AK-Homberger/NMEA2000-TempPressure/README.md

# NMEA2000 Temperature and Pressure
This repository shows how to  measure temperature and barometric pressure with a BMP280 sensor and send it to NMEA2000 network.

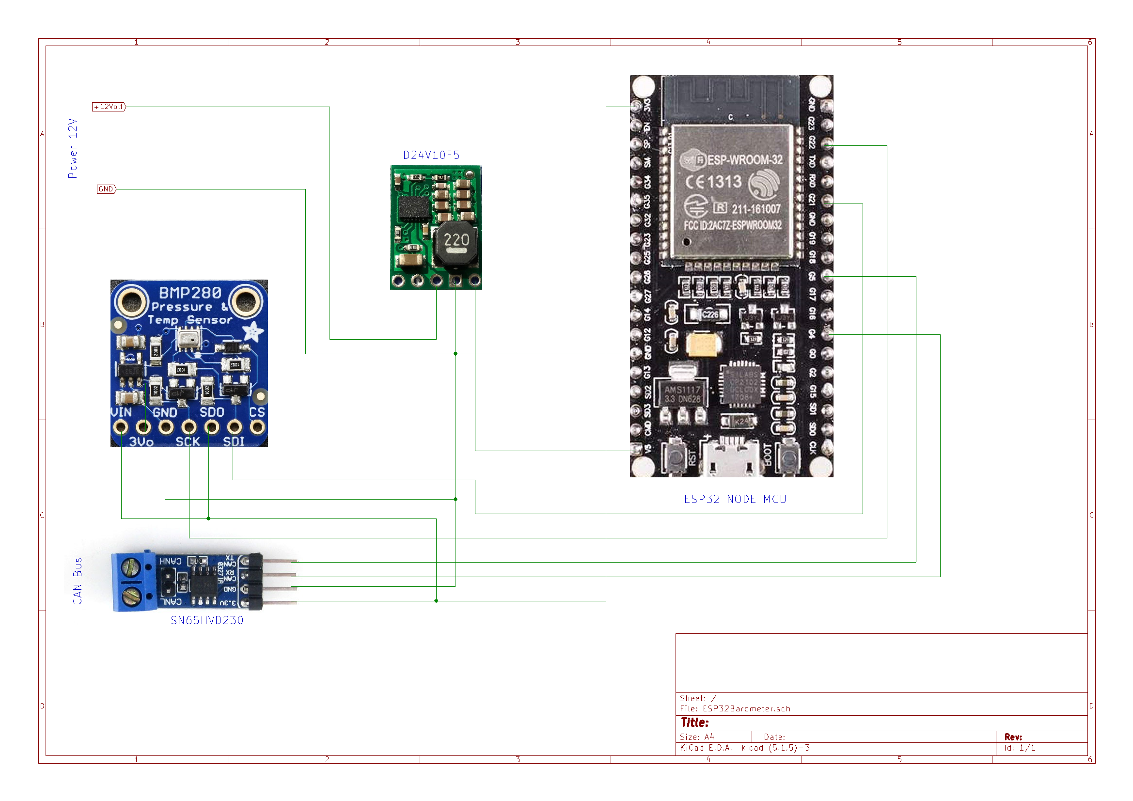
[picture p1: NMEA2000 Barometer.png]
Schematics


The BMP280 measures temperature and barometric pressure. Small PCBs can be bought from Adafruit or AZ-Delivery for example.

The data is sent to NMEA2000 network with PGN130310 (Outside Environmental Parameters)

The wiring is detailled in the schematics avove. 

The project requires the NMEA2000 and the NMEA2000_esp32 libraries from Timo Lappalainen: https://github.com/ttlappalainen. Both libraries have to be downloaded and installed.

For the BMP280 the Adafruit BMP280 library has to be installed via the library manager.

The ESP32 in this project is an ESP32 NODE MCU from AzDelivery. Pin layout for other ESP32 devices might differ.

For the ESP32 CAN bus, I used the "Waveshare SN65HVD230 Can Board" as transceiver. It works well with the ESP32. The correct GPIO ports are defined in the main sketch. For this project, I use the pins GPIO4 for CAN RX and GPIO5 for CAN TX.

The 12 Volt is reduced to 5 Volt with a DC Step-Down_Converter (D24V10F5).

If you want to use an BME280 device, you can have a look to NMEA2000 Workshop examples: https://github.com/AK-Homberger/NMEA2000-Workshop/tree/main/Software

# Remove the 120 ohm resistor from the transceiver
For unknown reasons, many CAN bus transceivers for the ESP32 have a 120 Ohm resistor built into them. The resistor does not belong to the devices at the ends of the stub lines, but to the ends of the backbone cable.

Whether the transceiver contains a 120 ohm resistor can be determined either by looking at the [circuit diagram](https://github.com/AK-Homberger/NMEA2000-Workshop/blob/main/Docs/SN65HVD230%20CAN%20Board_SCH.pdf) or by measuring with the multimeter.

A knife tip is suitable for removing the SMD resistor. Use it to scratch or pry off the resistance. With the transceiver shown here, place the tip of the knife in front of the resistor (between the chip and the resistor) and support the knife against the chip. Then lever the tip against the resistance and use it to scratch / loosen / break the resistance. Whichever happens first.

Transceiver

It then looks like the picture. Then measure to be on the safe side. Without a 120 ohm resistor, the multimeter shows approx. 75 kOhm.

# Partlist:

- ESP32 [Link](https://www.amazon.de/AZDelivery-NodeMCU-Development-Nachfolgermodell-ESP8266/dp/B071P98VTG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) 
- SN65HVD230 [Link](https://www.amazon.de/SN65HVD230-Board-Connecting-Communication-Development/dp/B00KM6XMXO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)
- D24V10F5 [Link](https://eckstein-shop.de/Pololu-5V-1A-Step-Down-Spannungsregler-D24V10F5)
- BMP280 [Link](https://www.amazon.de/AZDelivery-GY-BMP280-Barometrischer-Sensor-Luftdruckmessung/dp/B07D8TPVVY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)
- PCB universal set [Link](https://www.amazon.de/70Stk-Doppelseitig-Lochrasterplatte-Kit-Lochrasterplatine/dp/B07BDKG68Q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)
