AK-Homberger/NMEA2000-TempPressure/(threads)

Thread 1 (2020-12-21):

No Serial Output

Piccar, 2020-12-21:
Hi,
the Sketch compiles and even uploads to my Node MCU ESP32 from Joy-IT but I don't get any Serial Output. I even added some simple Debug messages before and after the Delay in Line 73.
I installed the necessary Libaries and made sure that the ENABLE_DEBUG_LOG ist set to 1.
I hope we can find my Mistake(s) soon....

Piccar, 2020-12-21:
My fault... did not checked wiring!

Closed 2020-12-21.
