AK-Homberger/NMEA2000-TempPressure/NMEA2000-Barometer/NMEA2000-Barometer.ino

/*
  This code is free software; you can redistribute it and/or
  modify it under the terms of the GNU Lesser General Public
  License as published by the Free Software Foundation; either
  version 2.1 of the License, or (at your option) any later version.
  This code is distributed in the hope that it will be useful,
  but WITHOUT ANY WARRANTY; without even the implied warranty of
  MERCHANTABILITY or FITNESS FOR A PARTICULAR PURPOSE.  See the GNU
  Lesser General Public License for more details.
  You should have received a copy of the GNU Lesser General Public
  License along with this library; if not, write to the Free Software
  Foundation, Inc., 51 Franklin St, Fifth Floor, Boston, MA  02110-1301  USA
*/

// NMEA2000 Temperature and Barometric Pressure with BMP280
// Version 0.2, 29.08.2020, AK-Homberger

#define ESP32_CAN_TX_PIN GPIO_NUM_5  // Set CAN TX port to 5 
#define ESP32_CAN_RX_PIN GPIO_NUM_4  // Set CAN RX port to 4

#include <Arduino.h>
#include <Preferences.h>
#include <NMEA2000_CAN.h>  // This will automatically choose right CAN library and create suitable NMEA2000 object
#include <N2kMessages.h>

#include <Wire.h>

#define BMP_SDA 21
#define BMP_SCL 22
#include <Adafruit_BMP280.h>  // Install Adafruit BMP280 library!!!
Adafruit_BMP280 bmp; // I2C 

// Connect VIN of the BMP280 sensor to 3.3V (NOT 5.0V!)
// Connect GND to Ground
// Connect SCL GPIO 22
// Connect SDA GPIO 21

#define ENABLE_DEBUG_LOG 0 // Debug log

int NodeAddress;  // To store last Node Address

double Temperature = 0;
double BarometricPressure = 0;

Preferences preferences;             // Nonvolatile storage on ESP32 - To store LastDeviceAddress

// Set the information for other bus devices, which messages we support

const unsigned long TransmitMessages[] PROGMEM = {130310L, // Outside Environmental parameters
                                                  0
                                                 };
// Send time offsets
#define TempSendOffset 0

#define SlowDataUpdatePeriod 1000  // Time between CAN Messages sent



void debug_log(char* str) {
#if ENABLE_DEBUG_LOG == 1
  Serial.println(str);
#endif
}


void setup() {
  uint8_t chipid[6];
  uint32_t id = 0;
  int i = 0;

  // Init USB serial port
  Serial.begin(115200);
  delay(10);

  if (!bmp.begin()) {
    Serial.println("Could not find a valid BMP280 sensor, check wiring!");
    while (1) {}
  }

  // Reserve enough buffer for sending all messages. This does not work on small memory devices like Uno or Mega

  NMEA2000.SetN2kCANMsgBufSize(8);
  NMEA2000.SetN2kCANReceiveFrameBufSize(250);
  NMEA2000.SetN2kCANSendFrameBufSize(250);

  esp_efuse_mac_get_default(chipid);
  for (i = 0; i < 6; i++) id += (chipid[i] << (7 * i));

  // Set product information
  NMEA2000.SetProductInformation("1", // Manufacturer's Model serial code
                                 100, // Manufacturer's product code
                                 "My Sensor Module",  // Manufacturer's Model ID
                                 "1.0.2.25 (2019-07-07)",  // Manufacturer's Software version code
                                 "1.0.2.0 (2019-07-07)" // Manufacturer's Model version
                                );
  // Set device information
  NMEA2000.SetDeviceInformation(id, // Unique number. Use e.g. Serial number.
                                130, // Device function=Temperature. See codes on http://www.nmea.org/Assets/20120726%20nmea%202000%20class%20&%20function%20codes%20v%202.00.pdf
                                75, // Device class=Sensor Communication Interface. See codes on  http://www.nmea.org/Assets/20120726%20nmea%202000%20class%20&%20function%20codes%20v%202.00.pdf
                                2046 // Just choosen free from code list on http://www.nmea.org/Assets/20121020%20nmea%202000%20registration%20list.pdf
                               );

  // If you also want to see all traffic on the bus use N2km_ListenAndNode instead of N2km_NodeOnly below

  NMEA2000.SetForwardType(tNMEA2000::fwdt_Text); // Show in clear text. Leave uncommented for default Actisense format.

  preferences.begin("nvs", false);                          // Open nonvolatile storage (nvs)
  NodeAddress = preferences.getInt("LastNodeAddress", 34);  // Read stored last NodeAddress, default 34
  preferences.end();
  Serial.printf("NodeAddress=%d\n", NodeAddress);

  NMEA2000.SetMode(tNMEA2000::N2km_ListenAndNode, NodeAddress);
  NMEA2000.ExtendTransmitMessages(TransmitMessages);

  NMEA2000.Open();
  
  delay(200);
}


bool IsTimeToUpdate(unsigned long NextUpdate) {
  return (NextUpdate < millis());
}
unsigned long InitNextUpdate(unsigned long Period, unsigned long Offset = 0) {
  return millis() + Period + Offset;
}

void SetNextUpdate(unsigned long & NextUpdate, unsigned long Period) {
  while ( NextUpdate < millis() ) NextUpdate += Period;
}



void SendN2kTempPressure(void) {
  static unsigned long SlowDataUpdated = InitNextUpdate(SlowDataUpdatePeriod, TempSendOffset);
  tN2kMsg N2kMsg;

  if ( IsTimeToUpdate(SlowDataUpdated) ) {
    SetNextUpdate(SlowDataUpdated, SlowDataUpdatePeriod);

    Temperature = bmp.readTemperature();
    BarometricPressure = bmp.readPressure();

    Serial.printf("Temperature: %3.1f °C - Barometric Pressure: %6.0f Pa\n", Temperature, BarometricPressure);

    SetN2kPGN130310(N2kMsg, 0, N2kDoubleNA, CToKelvin(Temperature), BarometricPressure);
    NMEA2000.SendMsg(N2kMsg);
  }
}



void loop() {
  
  SendN2kTempPressure();

  NMEA2000.ParseMessages();
  int SourceAddress = NMEA2000.GetN2kSource();
  if (SourceAddress != NodeAddress) { // Save potentially changed Source Address to NVS memory
    NodeAddress = SourceAddress;      // Set new Node Address (to save only once)
    preferences.begin("nvs", false);
    preferences.putInt("LastNodeAddress", SourceAddress);
    preferences.end();
    Serial.printf("Address Change: New Address=%d\n", SourceAddress);
  }

  // Dummy to empty input buffer to avoid board to stuck with e.g. NMEA Reader
  if ( Serial.available() ) {
    Serial.read();
  }

}
