AK-Homberger/NMEA2000-TempPressure/(commit log)

2020-08-29 Changed device identification values to sensor module.
2022-02-05 Use new ESP32-API function name "esp_efuse_mac_get_default(chipid);"
